AlexKlimaj/sloopdoorbot/Door System V1/README.md

Directional-Digital-Turnstile
=============================

This project aims to create a directional digital turnstile to serve as a doorbell and to gather statistics about the number of people in a facility.
