AlexKlimaj/sloopdoorbot/Door System V2/Case.stl

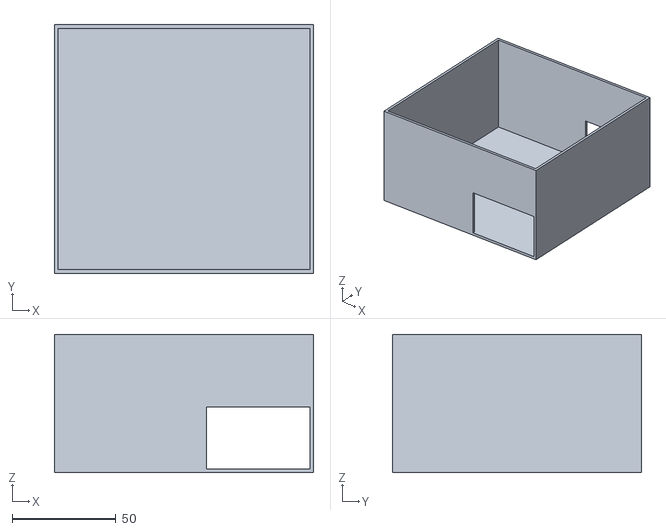
[picture p8: CAD file, 2015-10-02]
Door System V2/Case.stl
125.0 x 120.0 x 66.8
