AlexKlimaj/sloopdoorbot/Door System V1/Transmitter clamp.stl

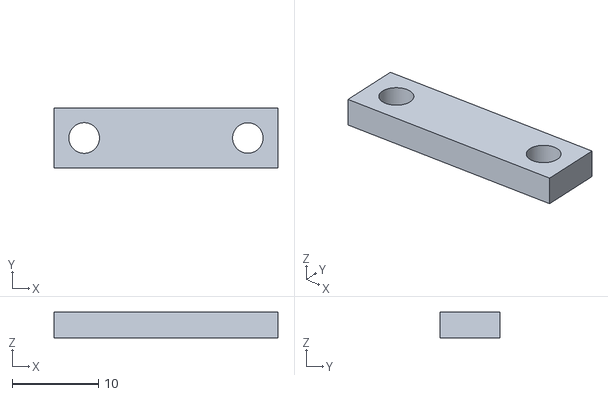
[picture p9: CAD file, 2015-10-02, an earlier design]
Door System V1/Transmitter clamp.stl
26.0 x 7.00 x 3.00
