AlexKlimaj/sloopdoorbot/Door System V1/Receiver Case top.stl

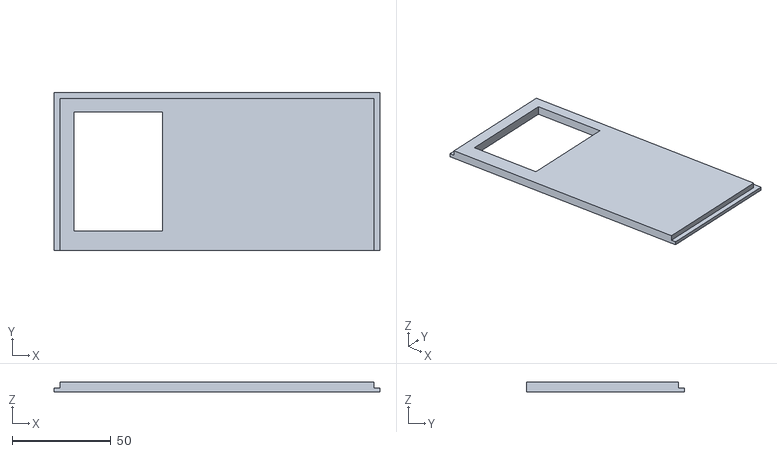
[picture p10: CAD file, 2015-10-02, an earlier design]
Door System V1/Receiver Case top.stl
165.0 x 80.0 x 5.00
