AlexKlimaj/sloopdoorbot/Door System V1/Receiver Case.stl

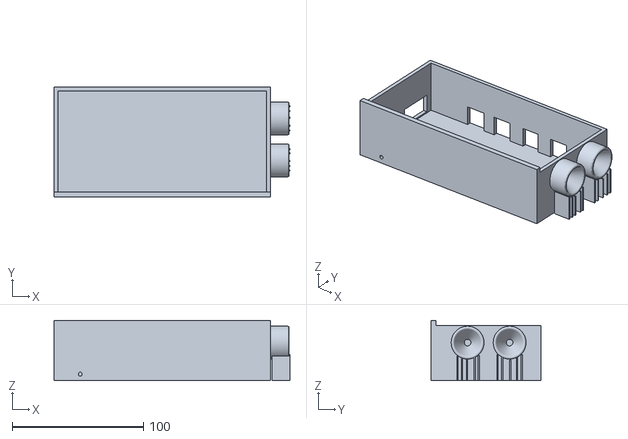
[picture p11: CAD file, 2015-10-02, an earlier design]
Door System V1/Receiver Case.stl
179.8 x 84.0 x 46.0
