AlexKlimaj/sloopdoorbot/Door System V1/Transmitter Case.stl

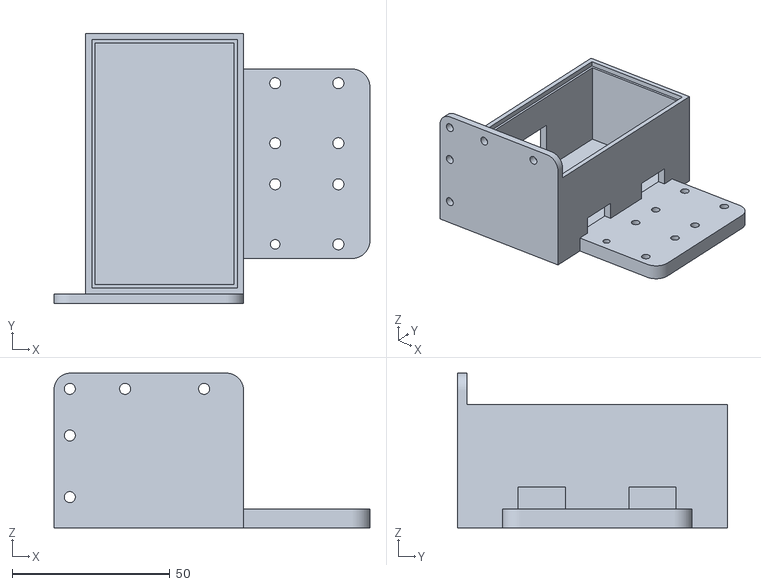
[picture p12: CAD file, 2015-10-02, an earlier design]
Door System V1/Transmitter Case.stl
100.0 x 85.5 x 49.0
