AlexKlimaj/sloopdoorbot/Door System V1/Transmitter Case Top.stl

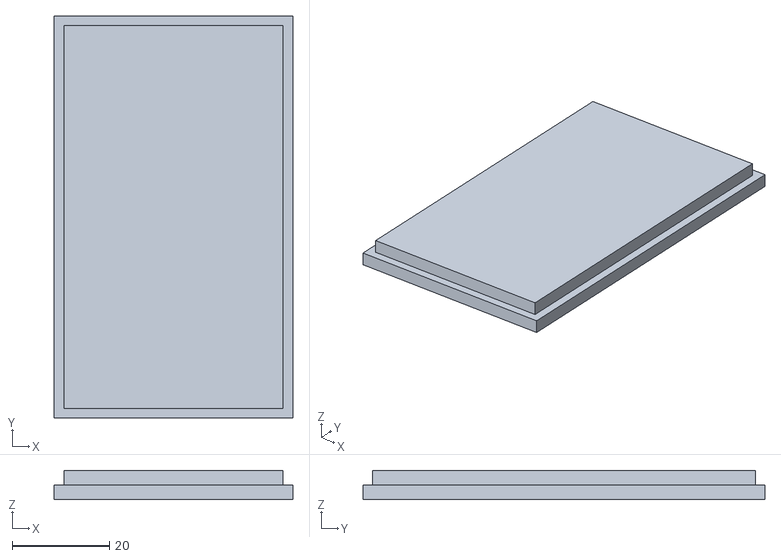
[picture p13: CAD file, 2015-10-02, an earlier design]
Door System V1/Transmitter Case Top.stl
49.0 x 82.5 x 6.00
