AlexKlimaj/sloopdoorbot/(list of files, cad)

Other CAD files:
Door System V1/Receiver Case top.ipt
Door System V1/Receiver Case.ipt
Door System V1/Transmitter Case Top.ipt
Door System V1/Transmitter Case.ipt
Door System V1/Transmitter clamp.ipt
Door System V2/Case.ipt
Door System V2/Lid.ipt
