AlexKlimaj/sloopdoorbot/Door System V1/Laser Trip Detector.brd

## EAGLE design Door System V1/Laser Trip Detector.brd (2015-10-02, an earlier design)

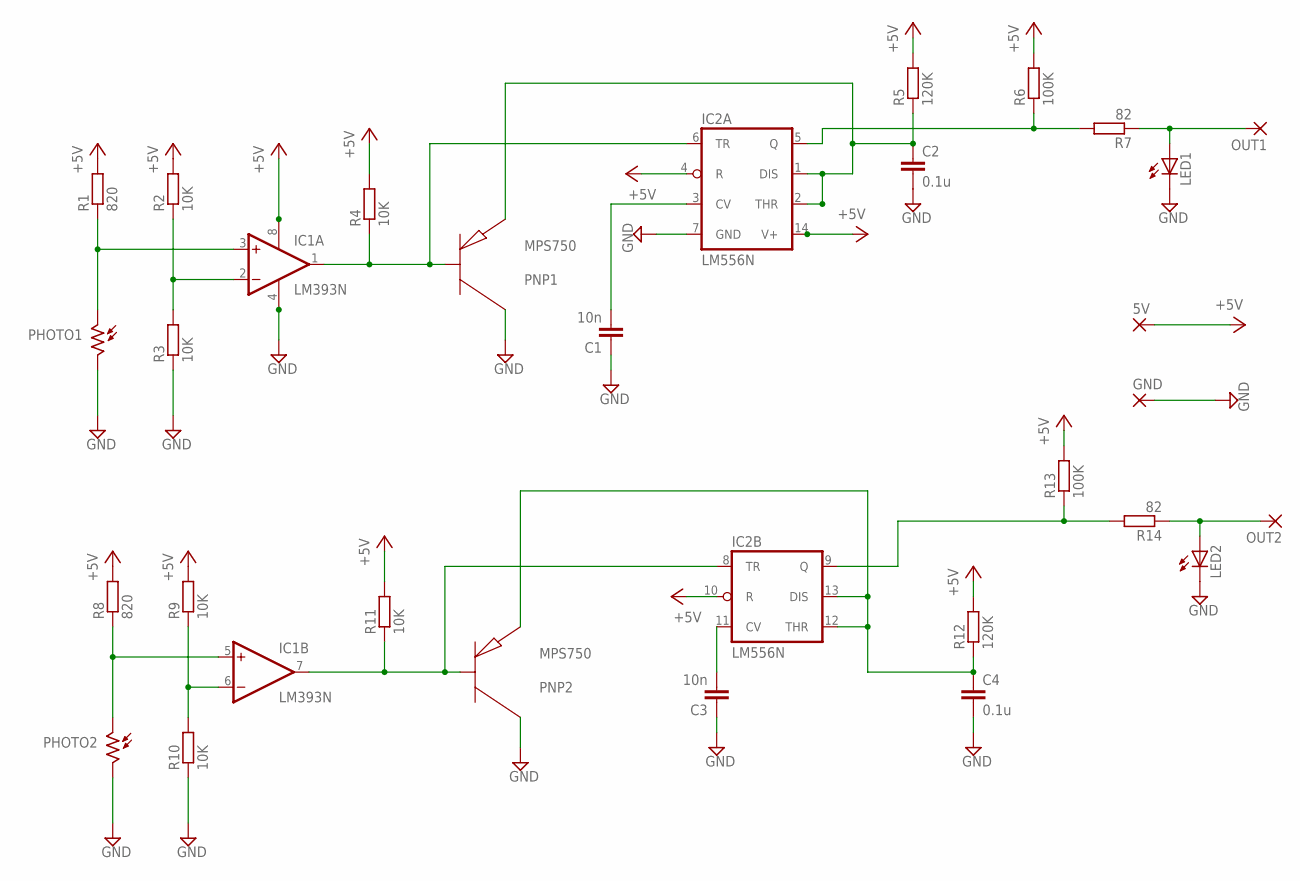
[picture p14: schematic Laser Trip Detector.sch]

Parts:
5V: 3,17/1,3
C1, C3: 10n; C5B3
C2, C4: 0.1u; C5B3
GND: 3,17/1,3
IC1: LM393N; DIL08
IC2: LM556N; DIL14
LED1, LED2: LED5MM
OUT1, OUT2: 3,17/1,3
PHOTO1, PHOTO2: M9960_11A; M9960
PNP1, PNP2: MPS750; TO92
R1, R8: 820; 0207/10
R2, R3, R4, R9, R10, R11: 10K; 0207/10
R5, R12: 120K; 0207/10
R6, R13: 100K; 0207/10
R7, R14: 82; 0207/10

Connections:
+5V: 5V.1, IC1.8 (V+), IC2.4 (R), IC2.10 (R), IC2.14 (V+), R1.2, R2.2, R4.2, R5.2, R6.2, R8.2, R9.2, R11.2, R12.2, R13.2
GND: C1.1, C2.2, C3.1, C4.2, GND.1, IC1.4 (V-), IC2.7 (GND), LED1.K (C), LED2.K (C), PHOTO1.2, PHOTO2.2, PNP1.1 (C), PNP2.1 (C), R3.1, R10.1
unnamed: IC1.2 (-IN), R2.1, R3.2
unnamed: IC1.3 (+IN), PHOTO1.1, R1.1
unnamed: IC1.1 (OUT), IC2.6 (TR), PNP1.2 (B), R4.1
unnamed: C1.2, IC2.3 (CV)
unnamed: C2.1, IC2.1 (DIS), IC2.2 (THR), PNP1.3 (E), R5.1
unnamed: IC2.5 (Q), R6.1, R7.2
unnamed: LED1.A, OUT1.1, R7.1
unnamed: IC1.6 (-IN), R9.1, R10.2
unnamed: IC1.5 (+IN), PHOTO2.1, R8.1
unnamed: IC1.7 (OUT), IC2.8 (TR), PNP2.2 (B), R11.1
unnamed: C3.2, IC2.11 (CV)
unnamed: C4.1, IC2.12 (THR), IC2.13 (DIS), PNP2.3 (E), R12.1
unnamed: IC2.9 (Q), R13.1, R14.2
unnamed: LED2.A, OUT2.1, R14.1

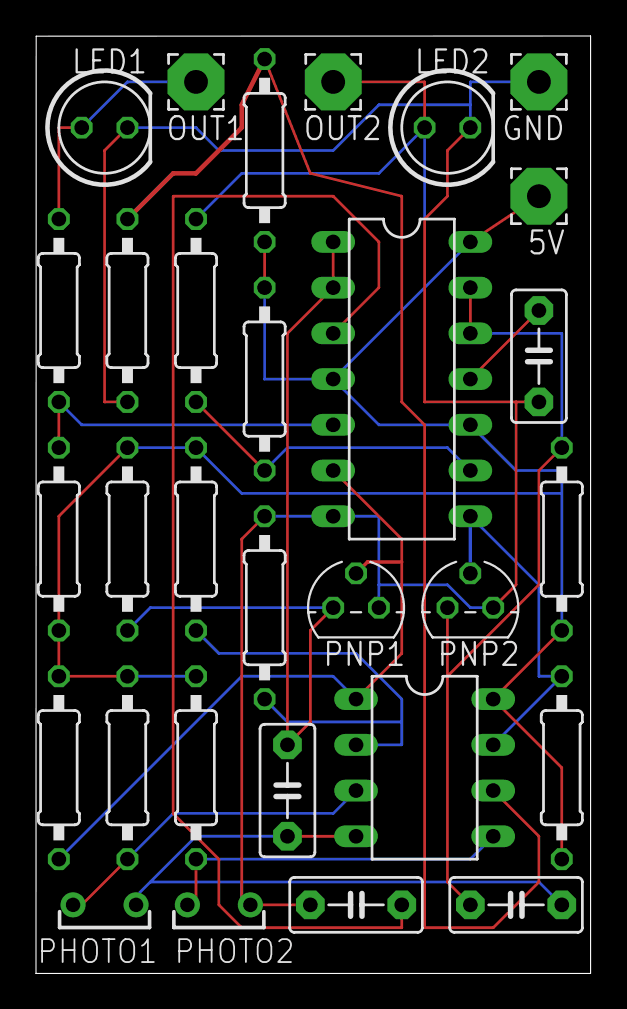
[picture p15: board Laser Trip Detector.brd from above]

Board: 2 copper layers, 30.8 x 52.1 mm, 30 parts (0 on the bottom side), 16 nets.
